WinTer1165/Multi-Gas-Safety-System-with-Voice-Alerts-Web-Dashboard/assets/Project_Configuration_Guide_V5.pdf

# STM32 Pin Configuration & MX Setup

### Hardware Pinout Connections:

STM32 Pin | Function | Connected Component | Notes
PA0 | ADC1_IN0 | MQ-2 Gas Sensor | Connect to AO (Analog Out)
PA1 | ADC1_IN1 | MQ-135 Gas Sensor | Connect to AO (Analog Out)
PA2 | ADC1_IN2 | MQ-7 Gas Sensor | Connect to AO (Analog Out)
PB0 | TIM3_CH3 | Buzzer | ~2 kHz PWM output
PB1 | GPIO_EXTI1 | Push Button | Triggers external interrupt (BTN_NEXT)
PB6 | I2C1_SCL | SSD1306 OLED | SCL line
PB7 | I2C1_SDA | SSD1306 OLED | SDA line
PC13 | GPIO_Output | Onboard LED | Heartbeat/alert indicator (LED_STATUS)
PA9 (TX) | USART1_TX | DFPlayer Mini | Play audio through the speaker
PA10 (RX) | USART1_RX | DFPlayer Mini | Play audio through the speaker
PB10 (TX) | USART2_TX | ESP8266 | Web App data transfer
PB11 (RX) | USART1_TX | ESP8266 | Web App data transfer

### STM32CubeMX Configuration Guide

### 1. Project Initialization

- Action: Go to File → New Project
- Target: Search for STM32F103C8 and select the STM32F103C8Tx
- Project Name: GasSafetySystem
- Toolchain/IDE: Select MDK-ARM (Keil)

### 2. System Core & RCC (Clock Source)

Under System Core → RCC:
- High Speed Clock (HSE): Crystal/Ceramic Resonator

### 3. Clock Tree Configuration (72 MHz)

Go to the Clock Configuration tab:
- Sets HCLK to 72 MHz

### 4. ADC1 Configuration (Sensor Inputs)

Under Analog → ADC1, enable IN0 (PA0), IN1 (PA1), and IN2 (PA2). Apply these parameter settings:
- Mode: Independent
- Data Alignment: Right

- Scan Conversion Mode: Disabled (simpler for software polling/averaging)
- Continuous / Discontinuous Mode: Disabled
- Number of Conversions: 1
- External Trigger: Regular Conversion launched by software
- Rank 1 / Channel: Channel 0
- Sampling Time: 71.5 Cycles (Helps with the high source impedance of MQ sensors)

### 5. I2C1 Configuration (OLED Display)

Under Connectivity → I2C1:
- I2C: I2C
- Speed Mode: Fast Mode
- Speed Frequency: 400 kHz
- Duty Cycle: 2
Note: Verify PB6 (SCL) and PB7 (SDA) are auto-assigned.

### 6. GPIO & Interrupts (Button & LED)

Button (PB1): Click PB1 in the pinout view and select GPIO_EXTI1.
- Under System Core → GPIO → PB1: Set Mode to External Interrupt Mode with Falling edge trigger detection
- Pull-up/Pull-down: Pull-up
- User Label: BTN_NEXT
- Under System Core → NVIC: Enable EXTI line1 interrupt (leave priority at default 0) Onboard LED (PC13): Click PC13 and select GPIO_Output.
- User Label: LED_STATUS

### 7. Timer Configuration (Buzzer PWM)

Under Timers → TIM3:
- Clock Source: Internal Clock
- Channel3: PWM Generation CH3 (Verify this auto-assigns to PB0)

Apply these parameter settings to achieve a ~2 kHz PWM signal:
- Prescaler (PSC): 71 (Timer clock = 72 MHz / 72 = 1 MHz)
- Counter Mode: Up
- Counter Period (ARR): 499 (PWM frequency = 1 MHz / 500 = 2 kHz)
- Internal Clock Division (CKD): No Division
- Auto-reload Preload: Disable
- Mode: PWM mode 1
- Pulse (CCR): 0 (Starts silent; adjust via code)
- Output Compare Preload: Disable
- Fast Mode: Disable
- CH Polarity: High

### 8. DFPlayer (Buzzer PWM)

Under Connectivity →USART1:
- Mode: Asynchronous
- Baud Rate: 9600 Bits/s
- Word Length: 8 Bits (including Parity)
- Stop Bits: 1
Note: Verify PA10 (RX) and PA9 (TX) are auto-assigned.

### 9. DFPlayer (Buzzer PWM)

Under Connectivity →USART3:
- Mode: Asynchronous
- Baud Rate: 9600 Bits/s
- Word Length: 8 Bits (including Parity)
- Stop Bits: 1
Note: Verify PB11 (RX) and PB10 (TX) are auto-assigned.

### 10. Final Project Settings

Click Generate Code

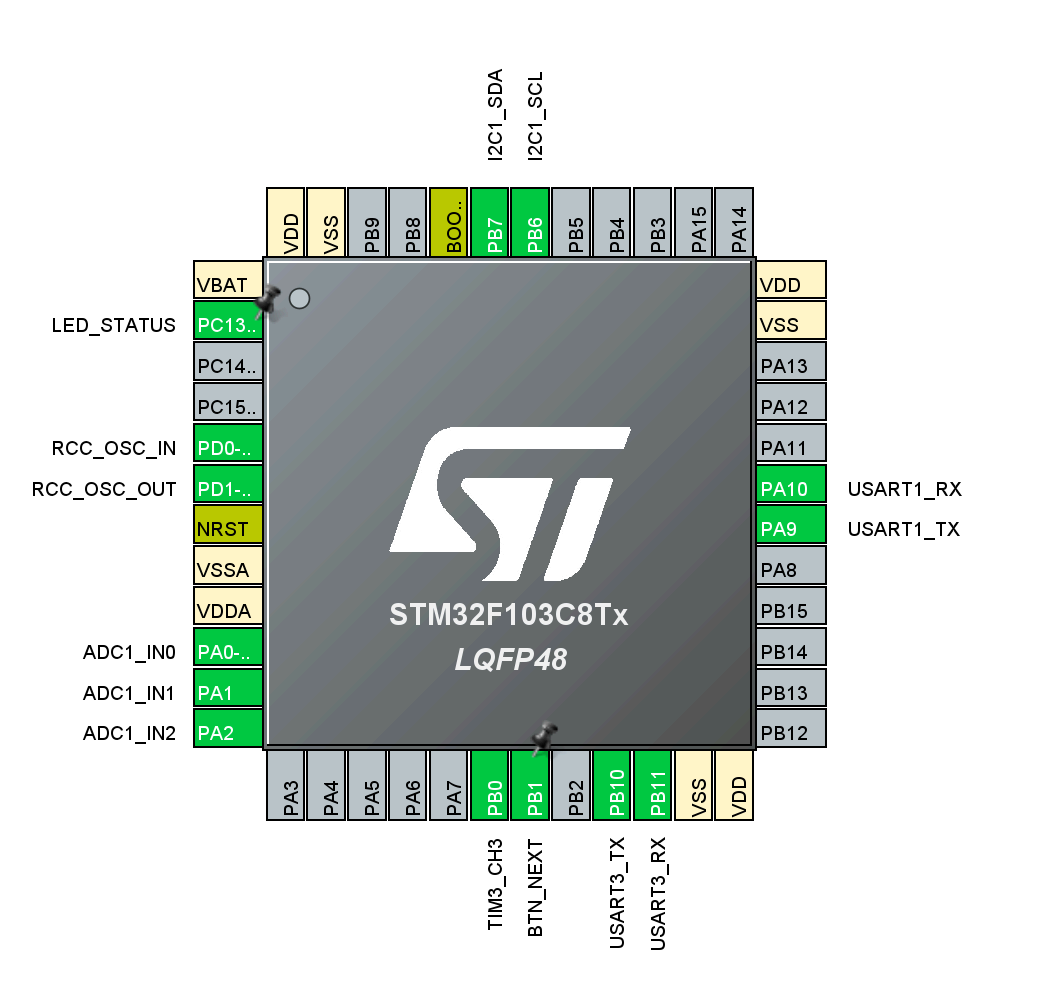
[picture p4: figure]

Figure 1: Final pinout
