WinTer1165/Multi-Gas-Safety-System-with-Voice-Alerts-Web-Dashboard/(notices)

Notices in the files:
firmware/main.c:
Copyright (c) 2026 STMicroelectronics.
All rights reserved.
This software is licensed under terms that can be found in the LICENSE file
